Quang-Luu-2005/DKHTM/readme.md

Mapping hiện tại:

  - COM3: camera Face Recognition.
  - COM10: camera stream + ESP-DL Face Detect một tầng.
  - COM11: mạch Automatic Gate gồm servo, RFID, HC‑SR04, LED/buzzer và MQTT.
