Quang-Luu-2005/DKHTM/slide/slide_updated.tex

\documentclass[aspectratio=169,11pt]{beamer}

\usetheme{Madrid}
\useinnertheme{circles}

\usepackage[utf8]{inputenc}
\usepackage[T5]{fontenc}
\usepackage[vietnamese]{babel}
\usepackage{booktabs}
\usepackage{array}
\usepackage{graphicx}
\usepackage{tikz}
\usetikzlibrary{arrows.meta,positioning}

% Bảng màu bám theo bản trình chiếu gốc.
\definecolor{Primary}{HTML}{3733B5}
\definecolor{PrimaryDark}{HTML}{282477}
\definecolor{Success}{HTML}{168A45}
\definecolor{Warning}{HTML}{D66A00}
\definecolor{Danger}{HTML}{C90000}
\definecolor{LightPurple}{HTML}{F1F0FA}
\definecolor{LightRed}{HTML}{FDEDED}
\definecolor{BodyText}{HTML}{161616}

\setbeamercolor{normal text}{fg=BodyText,bg=white}
\setbeamercolor{structure}{fg=Primary}
\setbeamercolor{title}{fg=BodyText,bg=white}
\setbeamercolor{subtitle}{fg=BodyText,bg=white}
\setbeamercolor{frametitle}{fg=white,bg=Primary}
\setbeamercolor{palette primary}{fg=white,bg=Primary}
\setbeamercolor{palette secondary}{fg=white,bg=PrimaryDark}
\setbeamercolor{palette tertiary}{fg=white,bg=Primary}
\setbeamercolor{author in head/foot}{fg=white,bg=PrimaryDark}
\setbeamercolor{title in head/foot}{fg=white,bg=Primary}
\setbeamercolor{date in head/foot}{fg=white,bg=PrimaryDark}
\setbeamercolor{block title}{fg=white,bg=PrimaryDark}
\setbeamercolor{block body}{fg=BodyText,bg=LightPurple}
\setbeamercolor{block title alerted}{fg=white,bg=Danger}
\setbeamercolor{block body alerted}{fg=BodyText,bg=LightRed}

\setbeamerfont{title}{size=\Large,series=\bfseries}
\setbeamerfont{subtitle}{size=\normalsize}
\setbeamerfont{frametitle}{size=\large,series=\mdseries}
\setbeamerfont{normal text}{size=\normalsize}
\setbeamerfont{footline}{size=\tiny}

\setbeamertemplate{blocks}[rounded][shadow=true]
\setbeamertemplate{navigation symbols}{}
\setbeamertemplate{headline}{}
\setbeamertemplate{footline}{%
  \leavevmode%
  \hbox{%
    \begin{beamercolorbox}[wd=.30\paperwidth,ht=2.2ex,dp=.8ex,center]{author in head/foot}%
      \usebeamerfont{footline}\insertshortauthor\ (HCMUS)
    \end{beamercolorbox}%
    \begin{beamercolorbox}[wd=.38\paperwidth,ht=2.2ex,dp=.8ex,center]{title in head/foot}%
      \usebeamerfont{footline}\insertshorttitle
    \end{beamercolorbox}%
    \begin{beamercolorbox}[wd=.22\paperwidth,ht=2.2ex,dp=.8ex,center]{date in head/foot}%
      \usebeamerfont{footline}\insertshortdate
    \end{beamercolorbox}%
    \begin{beamercolorbox}[wd=.10\paperwidth,ht=2.2ex,dp=.8ex,center]{title in head/foot}%
      \usebeamerfont{footline}\insertframenumber
    \end{beamercolorbox}%
  }%
}

\hypersetup{
  unicode=true,
  pdftitle={Hệ thống kiểm soát ra vào thông minh - Báo cáo cuối kỳ và đánh giá mức độ đáp ứng mục tiêu},
  pdfauthor={Lưu Huy Minh Quang, Hoàng Nhân, Trần Cao Vân, Nguyễn Trần Thiên Phú},
  pdfsubject={Đánh giá sản phẩm AIoT với camera, RFID và Web Sentinel}
}

\title[Kiểm soát ra vào AIoT]{Hệ thống kiểm soát ra vào thông minh}
\subtitle{Báo cáo cuối kỳ và đánh giá mức độ đáp ứng mục tiêu}
\author[Nhóm thực hiện]{Lưu Huy Minh Quang \and Hoàng Nhân \and Trần Cao Vân \and Nguyễn Trần Thiên Phú}
\institute[HCMUS]{Khoa Công nghệ Thông tin\\Đại học Khoa học Tự nhiên, ĐHQG TP.HCM}
\date[Tháng 8 năm 2026]{Tháng 8 năm 2026}

\begin{document}

% Trang 1
\begin{frame}[c]
  \centering
  {\usebeamerfont{title}\inserttitle\par}
  \vspace{0.25em}
  {\usebeamerfont{subtitle}\insertsubtitle\par}

  \vspace{1em}
  {\large\bfseries Nhóm thực hiện}\par
  \vspace{0.4em}
  \begin{tabular}{ll}
    Lưu Huy Minh Quang & 23127016 \\
    Hoàng Nhân & 23127094 \\
    Trần Cao Vân & 23127141 \\
    Nguyễn Trần Thiên Phú & 23127246
  \end{tabular}

  \vspace{0.75em}
  \textsl{Khoa Công nghệ Thông tin -- ĐH Khoa học Tự nhiên, ĐHQG TP.HCM}\\
  \textsl{Môn: Nhập môn lập trình điều khiển thiết bị thông minh}

  \vspace{0.7em}
  \insertdate
\end{frame}

% Trang 2
\begin{frame}{Nội dung trình bày}
  \vspace{1.5em}
  \begin{enumerate}
    \item Sản phẩm cuối cùng đang làm được gì?
    \item Các phần từng chưa hoàn thành nay ở trạng thái nào?
    \item Đồ án đáp ứng ba mục tiêu ban đầu đến đâu?
    \item Kết luận và phạm vi của phiên bản hiện tại
  \end{enumerate}
\end{frame}

% Trang 3
\begin{frame}{Kết luận sau khi rà soát toàn bộ đồ án}
  \begin{block}{Sản phẩm đã thành hình ở mức nguyên mẫu một cổng}
    Người dùng có thể đăng ký hồ sơ, dùng khuôn mặt hoặc thẻ để xác thực, mở cổng tự động và theo dõi sự kiện trên trang quản lý.
  \end{block}

  \begin{itemize}
    \item \textbf{\color{Success}Hoàn thành:} nhận diện khuôn mặt, xác thực thẻ, điều khiển cổng, lưu hồ sơ và gửi cảnh báo.
    \item \textbf{\color{Success}Hoàn thành phát hiện hành vi trèo:} cảm biến siêu âm báo vi phạm khi có vật thể trong vùng kiểm soát lúc cổng chưa mở.
    \item \textbf{\color{Warning}Hạn chế:} toàn bộ quá trình nhận diện mất khoảng 5--7 giây.
  \end{itemize}
\end{frame}

% Trang 4
\begin{frame}{Sản phẩm cuối cùng trên trang quản lý}
  \centering
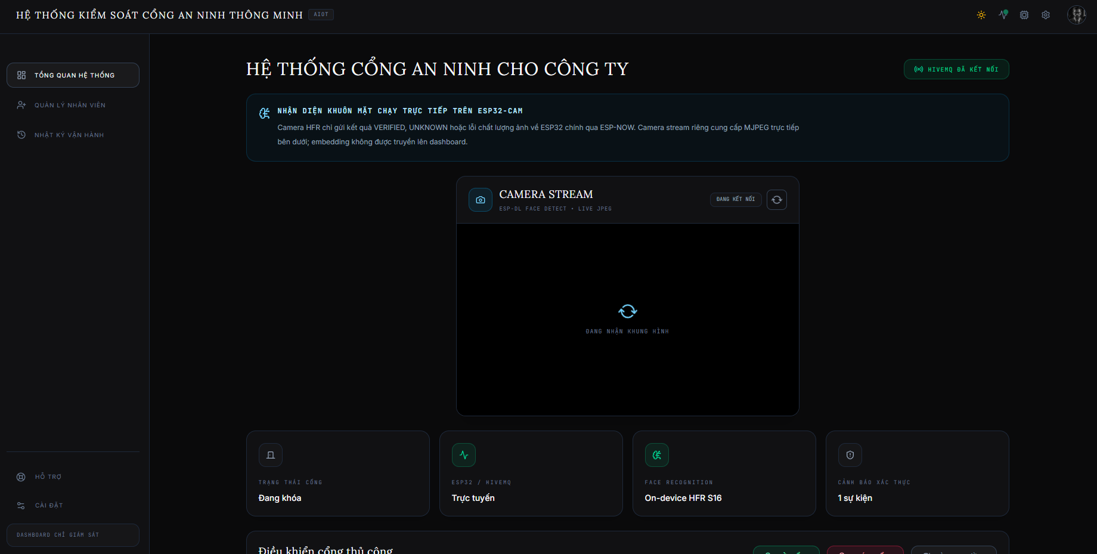
[picture p1: slide/assets/dashboard-overview.png]
  

  \vspace{0.35em}
  \begin{beamercolorbox}[rounded=true,sep=0.55em,wd=0.94\textwidth]{block body}
    \centering\small
    Camera trực tiếp \quad--\quad Trạng thái cổng \quad--\quad Cảnh báo \quad--\quad Điều khiển thủ công
  \end{beamercolorbox}
\end{frame}

% Trang 5
\begin{frame}{Một lượt ra vào diễn ra như thế nào?}
  \centering
  \vspace{0.8em}
  \begin{tikzpicture}[
    node distance=0.42cm,
    flowbox/.style={rounded corners=4pt,draw=Primary,fill=Primary!5,
      minimum width=2.15cm,minimum height=1.3cm,text width=1.9cm,
      align=center,font=\small\bfseries,inner sep=5pt},
    flowarr/.style={-{Stealth[length=2.2mm]},thick,draw=Primary}
  ]
    \node[flowbox] (arrival) {Có người\\đến cổng};
    \node[flowbox,right=of arrival] (identity) {Nhận diện mặt\\hoặc đọc thẻ};
    \node[flowbox,right=of identity] (access) {Kiểm tra\\quyền ra vào};
    \node[flowbox,right=of access] (gate) {Mở cổng\\hoặc giữ khóa};
    \node[flowbox,right=of gate] (history) {Ghi lịch sử\\và cảnh báo};

    \draw[flowarr] (arrival) -- (identity);
    \draw[flowarr] (identity) -- (access);
    \draw[flowarr] (access) -- (gate);
    \draw[flowarr] (gate) -- (history);
  \end{tikzpicture}

  \vspace{1em}
  \begin{block}{Điểm thay đổi so với thiết kế cũ}
    Trang quản lý có thể xem trực tiếp luồng camera tại cổng. Việc nhận diện vẫn được xử lý ngay trên camera và kết quả xác thực được gửi về mạch cổng.
  \end{block}
\end{frame}

% Trang 6
\begin{frame}{Các phần từng chưa hoàn thành: kết quả cuối (1/2)}
  \begin{columns}[T,onlytextwidth]
    \column{0.59\textwidth}
      \centering
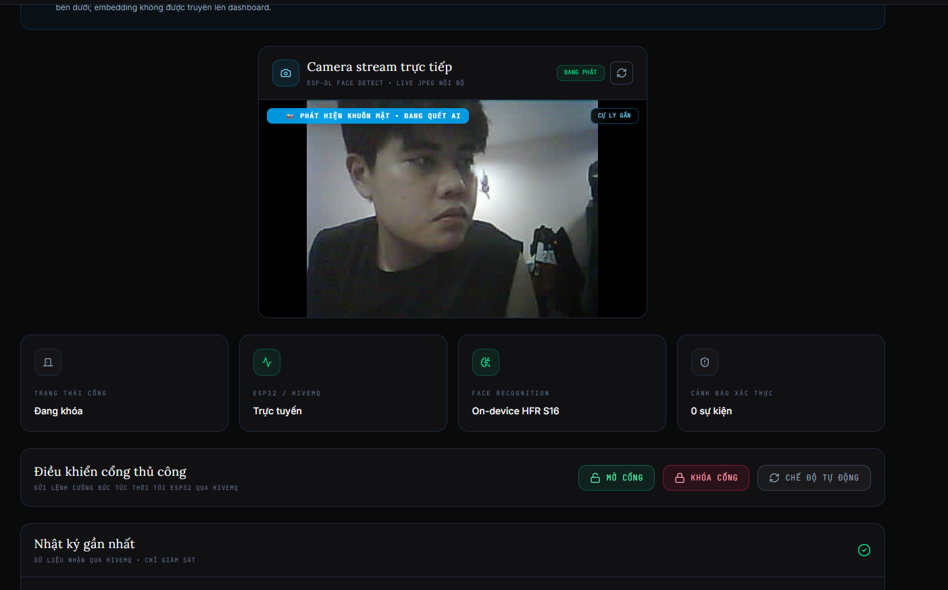
[picture p2: slide/assets/camera-stream.png]
      

      \vspace{0.25em}
      {\footnotesize Luồng camera trực tiếp và trạng thái nhận diện trên dashboard.}

    \column{0.37\textwidth}
      \small
      \begin{itemize}
        \item \textbf{\color{Success}Nhận diện khuôn mặt -- Hoàn thành}

        Đăng ký ba góc mặt và xử lý ngay trên camera.
        \item \textbf{\color{Success}Luồng camera -- Hoàn thành}

        Hình ảnh trực tiếp được hiển thị trên trang quản lý.
        \item \textbf{\color{Success}Phân nhóm email -- Hoàn thành}

        Cảnh báo được gửi đúng vai trò.
      \end{itemize}
  \end{columns}
\end{frame}

% Trang 7
\begin{frame}{Các phần từng chưa hoàn thành: kết quả cuối (2/2)}
  \vspace{1.5em}
  \begin{itemize}
    \item \textbf{\color{Success}Phát hiện trèo -- Hoàn thành:} khi cổng chưa mở mà cảm biến siêu âm phát hiện vật thể trong vùng kiểm soát, hệ thống xác định đây là vi phạm, tiếp tục khóa cổng và gửi cảnh báo.
    \item \textbf{\color{Success}Khôi phục kết nối -- Hoàn thành:} mạch và trang quản lý tự kết nối lại khi Wi-Fi hoặc kênh truyền bị gián đoạn ngắn.
  \end{itemize}
\end{frame}

% Trang 8
\begin{frame}{Mục tiêu 1: Nhận diện được, nhưng phản hồi còn chậm}
  \begin{columns}[T,onlytextwidth]
    \column{0.64\textwidth}
      \small
      \begin{block}{Mục tiêu ban đầu}
        Tối đa 20 người; độ chính xác trên 95\%; phản hồi dưới 1,5 giây.
      \end{block}

      \begin{itemize}
        \item Đăng ký ba góc mặt và lưu dữ liệu trên camera.
        \item Tự nhận diện, kiểm tra quyền và mở cổng khi khớp.
        \item Thời gian phản hồi thực tế: khoảng 5--7 giây.
      \end{itemize}

      \begin{alertblock}{Đánh giá}
        \textbf{Đạt chức năng, chưa đạt mục tiêu tốc độ.}
      \end{alertblock}

    \column{0.32\textwidth}
      \centering
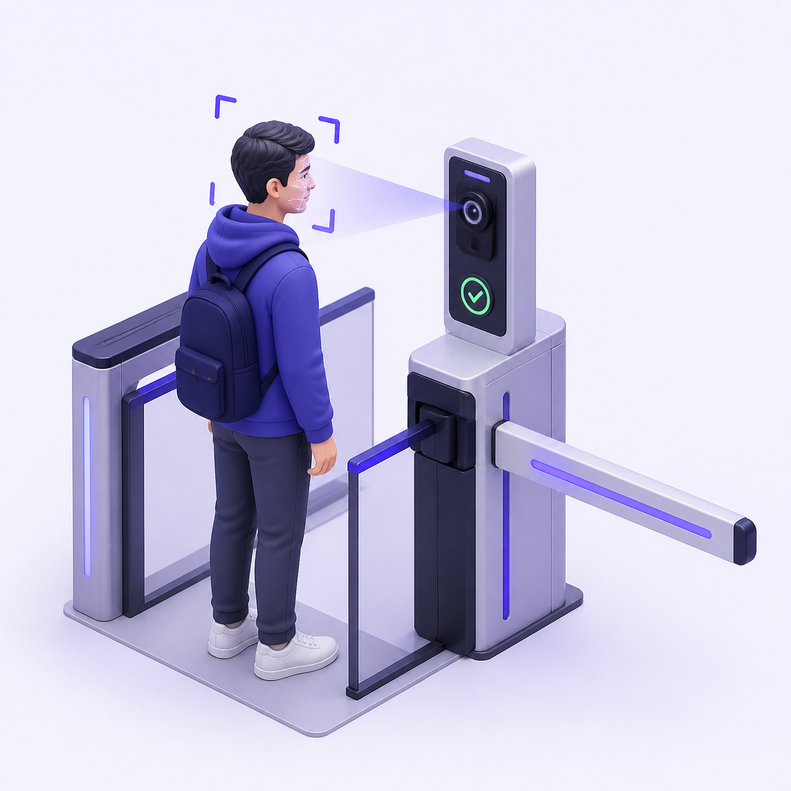
[picture p3: slide/assets/face-recognition.png]
      
      \vspace{0.25em}

      {\footnotesize Nhận diện được xử lý ngay tại camera.}
  \end{columns}
\end{frame}

% Trang 9
\begin{frame}{Mục tiêu 2: Phát hiện trèo bằng cảm biến siêu âm}
  \begin{columns}[T,onlytextwidth]
    \column{0.57\textwidth}
      \small
      \begin{block}{Mục tiêu ban đầu}
        Phát hiện vượt cổng trái phép, giữ khóa và gửi cảnh báo.
      \end{block}

      \begin{itemize}
        \item Cảm biến theo dõi vùng kiểm soát khi cổng đóng.
        \item Có vật thể bất thường: giữ khóa và gửi cảnh báo.
        \item Cổng đã mở hợp lệ: không kích hoạt cảnh báo.
      \end{itemize}

      \begin{alertblock}{Đánh giá}
        \textbf{Đạt mục tiêu phát hiện và cảnh báo.}
      \end{alertblock}

    \column{0.39\textwidth}
      \centering
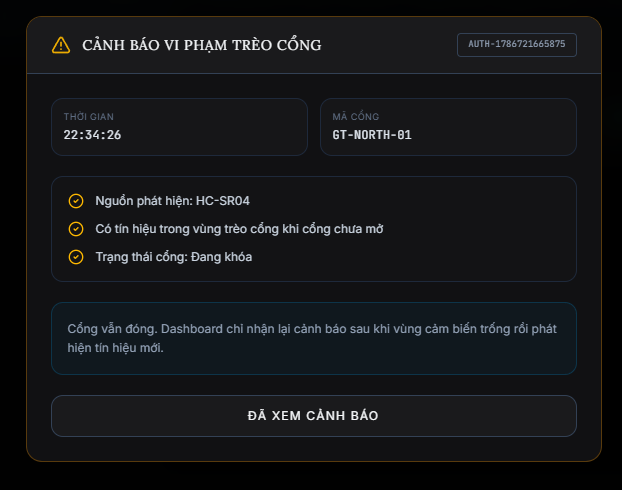
[picture p4: slide/assets/violation-alert.png]
      
      \vspace{0.25em}

      {\footnotesize Cảnh báo thực tế từ cảm biến HC-SR04.}
  \end{columns}
\end{frame}

% Trang 10
\begin{frame}{Mục tiêu 3: Luồng RFID/NFC hoàn chỉnh}
  \begin{columns}[T,onlytextwidth]
    \column{0.64\textwidth}
      \small
      \begin{block}{Mục tiêu ban đầu}
        Xác thực và mở cổng dưới 2 giây; độ chính xác tối thiểu 98\%.
      \end{block}

      \begin{itemize}
        \item Quét, gán và phân biệt thẻ hợp lệ hoặc không hợp lệ.
        \item Danh sách thẻ được lưu ngay trên mạch để xử lý nhanh.
        \item Mở cổng, đổi đèn và ghi lịch sử tại chỗ.
      \end{itemize}

      \begin{alertblock}{Đánh giá}
        \textbf{Đạt mục tiêu chức năng.}
      \end{alertblock}

    \column{0.32\textwidth}
      \centering
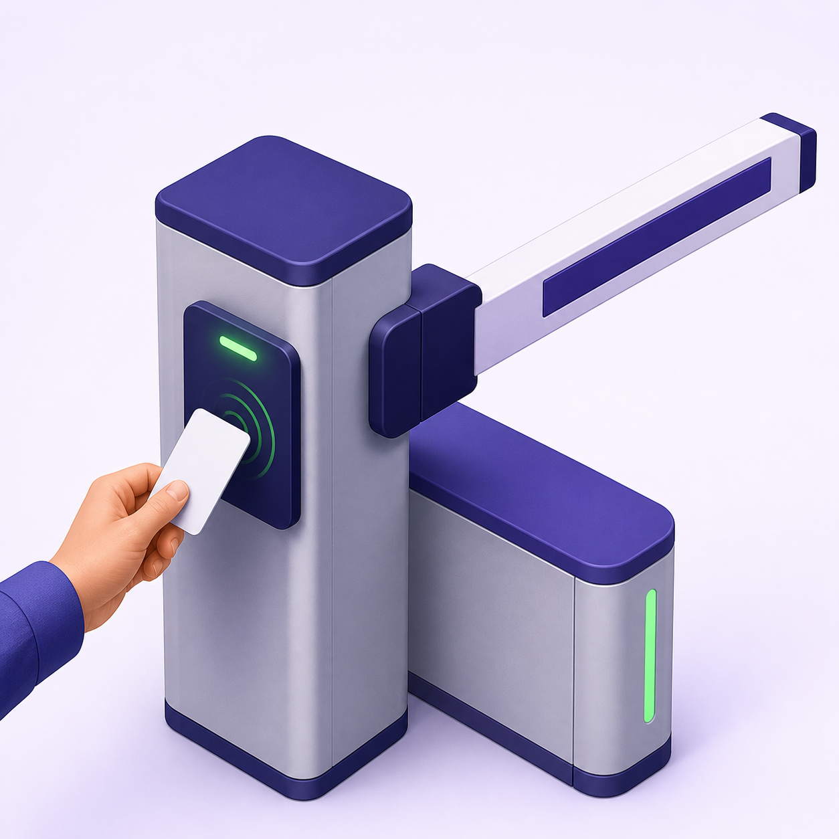
[picture p5: slide/assets/rfid-access.png]
      
      \vspace{0.25em}

      {\footnotesize Thẻ được kiểm tra trực tiếp tại cổng.}
  \end{columns}
\end{frame}

% Trang 11
\begin{frame}{Tổng hợp mức độ đáp ứng ba mục tiêu}
  \centering
  \small
  \renewcommand{\arraystretch}{1.32}
  \begin{tabular}{>{\raggedright\arraybackslash}p{2.45cm}
                  >{\raggedright\arraybackslash}p{5.35cm}
                  >{\raggedright\arraybackslash}p{3.0cm}}
    \toprule
    \textbf{Mục tiêu} & \textbf{Kết quả sản phẩm} & \textbf{Mức đáp ứng} \\
    \midrule
    Nhận diện người
      & Nhận diện và mở cổng; toàn bộ quá trình mất khoảng 5--7 giây
      & \textbf{\color{Warning}Đạt chức năng, còn chậm} \\
    Phát hiện trèo hoặc vượt cổng
      & Cảm biến phát hiện vật thể khi cổng chưa mở, giữ khóa và gửi cảnh báo
      & \textbf{\color{Success}Đạt} \\
    RFID/NFC
      & Quét thẻ, kiểm tra quyền, mở cổng và ghi lịch sử
      & \textbf{\color{Success}Đạt} \\
    \bottomrule
  \end{tabular}
\end{frame}

% Trang 12
\begin{frame}{Kiến trúc sản phẩm cuối cùng}
  \centering
  \begin{tikzpicture}[
    node distance=0.75cm and 0.75cm,
    archbox/.style={rounded corners=5pt,minimum width=3.05cm,minimum height=1.55cm,
      text width=2.75cm,align=center,font=\small\bfseries,inner sep=6pt,thick},
    archarr/.style={-{Stealth[length=2.4mm]},thick,draw=Primary},
    syncarr/.style={{Stealth[length=2.4mm]}-{Stealth[length=2.4mm]},thick,draw=Warning}
  ]
    \node[archbox,draw=Primary,fill=Primary!6] (input)
      {Thiết bị đầu vào\\{\footnotesize Camera + thẻ + cảm biến}};
    \node[archbox,draw=PrimaryDark,fill=Primary!10,right=of input] (control)
      {Mạch điều khiển cổng\\{\footnotesize Kiểm tra quyền ra vào}};
    \node[archbox,draw=Success,fill=Success!8,right=of control] (output)
      {Thiết bị phản hồi\\{\footnotesize Servo + đèn + còi}};
    \node[archbox,draw=Warning,fill=Warning!7,below=0.85cm of control] (web)
      {Trang quản lý\\{\footnotesize Hồ sơ + lịch sử + email}};

    \draw[archarr] (input) -- (control);
    \draw[archarr] (control) -- (output);
    \draw[syncarr] (control) -- node[left,font=\footnotesize]{Trạng thái / lệnh đăng ký} (web);
  \end{tikzpicture}

  \vspace{0.65em}
  \begin{minipage}{0.96\textwidth}
    \small
    \textbf{Nguyên tắc chính:} nhận diện được xử lý ngay tại camera; mạch cổng quyết định mở hoặc đóng; trang quản lý dùng để quản lý hồ sơ, theo dõi và nhận cảnh báo.
  \end{minipage}
\end{frame}

% Trang 13
\begin{frame}{Phạm vi của phiên bản cuối}
  \vspace{1em}
  \begin{columns}[T,onlytextwidth]
    \column{0.48\textwidth}
      \textbf{Có thể trình diễn}
      \begin{itemize}
        \item Đăng ký hồ sơ, khuôn mặt và thẻ.
        \item Mở cổng bằng khuôn mặt hoặc RFID.
        \item Phát hiện trèo khi cảm biến có tín hiệu lúc cổng chưa mở.
        \item Từ chối người hoặc thẻ không hợp lệ.
        \item Hiển thị lịch sử và gửi cảnh báo.
      \end{itemize}

    \column{0.48\textwidth}
      \textbf{Giới hạn còn lại}
      \begin{itemize}
        \item Toàn bộ quá trình nhận diện khuôn mặt cần khoảng 5--7 giây.
        \item Nhật ký chủ yếu được lưu trên trình duyệt đang sử dụng.
      \end{itemize}
  \end{columns}
\end{frame}

% Trang 14
\begin{frame}{Kết luận}
  \begin{block}{Kết quả cuối kỳ}
    Nhóm đã xây dựng được một nguyên mẫu kiểm soát ra vào có đủ luồng người dùng, thiết bị và trang quản lý để trình diễn. Điểm mạnh là xác thực RFID và nhận diện khuôn mặt ngay trên thiết bị.
  \end{block}

  \vspace{0.35em}
  \begin{alertblock}{Kết luận so với ba mục tiêu}
    Mục tiêu 2 và 3 đạt yêu cầu trong sản phẩm. Mục tiêu 1 đạt chức năng phát hiện và nhận diện người dùng, nhưng toàn bộ quá trình mất khoảng 5--7 giây, chậm hơn mục tiêu ban đầu.
  \end{alertblock}

  \vfill
  \centering
  {\Large\bfseries Hỏi đáp và thảo luận}
\end{frame}

\end{document}
