Quang-Luu-2005/DKHTM/Project2/Feature slide/slide/figures/Luồng RFIDNFC.png

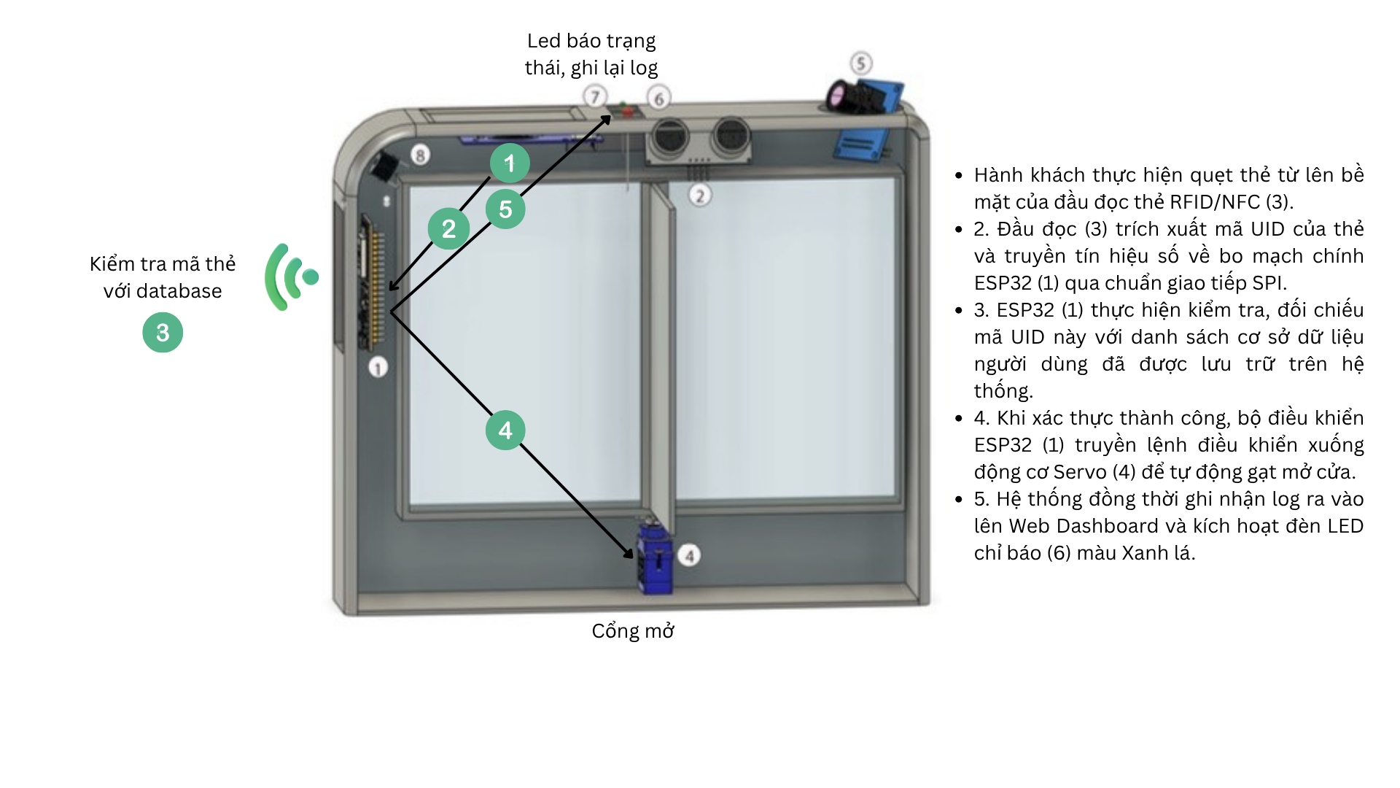
Project2/Feature slide/slide/figures/Luồng RFIDNFC.png
