Quang-Luu-2005/DKHTM/source/hardware/mqtt_main_controller/include/Gate.h

#include <ESP32Servo.h>

const int GATE_OPEN_DURATION = 1000;
const int GATE_OPEN_ANGLE = 70;
const int GATE_CLOSE_ANGLE = 0;

enum GATE_STATE {
  GATE_CLOSED,
  GATE_OPEN,
};

struct Gate {
  int pin;
  int angle;
  GATE_STATE state;
  unsigned long timer;

  Servo servo;
  Gate(int pin);
  void init();
  void open();
  void close();
};
