Quang-Luu-2005/DKHTM/source/hardware/esp32cam_node/json_utils.h

#pragma once

#include <Arduino.h>

#include "app_state.h"
#include "config.h"

static String escapeJson(const String& value) {
  String escaped;
  escaped.reserve(value.length() + 8);

  for (size_t i = 0; i < value.length(); ++i) {
    const char ch = value.charAt(i);
    switch (ch) {
      case '\\':
        escaped += "\\\\";
        break;
      case '"':
        escaped += "\\\"";
        break;
      case '\n':
        escaped += "\\n";
        break;
      case '\r':
        escaped += "\\r";
        break;
      case '\t':
        escaped += "\\t";
        break;
      default:
        escaped += ch;
        break;
    }
  }

  return escaped;
}

static String normalizeIdentityName(String value) {
  value.trim();
  value.replace("\n", " ");
  value.replace("\r", " ");
  value.replace("\t", " ");

  while (value.indexOf("  ") >= 0) {
    value.replace("  ", " ");
  }

  if (value.length() > kMaxEnrollNameLength) {
    value = value.substring(0, kMaxEnrollNameLength);
    value.trim();
  }

  return value;
}

static bool queryFlag(const char* name, bool defaultValue = false) {
  if (!webServer.hasArg(name)) {
    return defaultValue;
  }

  String value = webServer.arg(name);
  value.trim();
  value.toLowerCase();
  return value == "1" || value == "true" || value == "yes" || value == "on";
}

static int queryInt(const char* name, int defaultValue, int minValue, int maxValue) {
  if (!webServer.hasArg(name)) {
    return defaultValue;
  }

  int value = webServer.arg(name).toInt();
  if (value < minValue) {
    return minValue;
  }
  if (value > maxValue) {
    return maxValue;
  }
  return value;
}

static String faceRecognitionMode() {
  return "embedding/backend-match";
}
