Quang-Luu-2005/DKHTM/source/hardware/esp32cam_gateway/include/wifi_secrets.example.h

#pragma once

// Copy this file to wifi_secrets.h and use the same 2.4 GHz Wi-Fi as the gate ESP32.
constexpr const char* WIFI_SSID = "YOUR_2_4_GHZ_WIFI";
constexpr const char* WIFI_PASSWORD = "YOUR_WIFI_PASSWORD";
