Quang-Luu-2005/DKHTM/source/hardware/mqtt_main_controller/include/MQTT_secrets.example.h

#pragma once

// Copy this file to MQTT_secrets.h and fill in the local credentials.
constexpr const char* WIFI_SSID = "YOUR_WIFI_SSID";
constexpr const char* WIFI_PASSWORD = "YOUR_WIFI_PASSWORD";
constexpr const char* MQTT_SERVER = "YOUR_CLUSTER.s1.eu.hivemq.cloud";
constexpr const char* MQTT_USERNAME = "YOUR_MQTT_USERNAME";
constexpr const char* MQTT_PASSWORD = "YOUR_MQTT_PASSWORD";
