Quang-Luu-2005/DKHTM/(commit log)

2026-05-29 Add presentation on Smart Security Door using Face Recognition
    - Introduced a new Beamer presentation titled "Cửa an ninh xác thực bằng khuôn mặt"
    - Included sections covering project introduction, technology selection, proposed methods, and system architecture
    - Detailed the use of YOLOv11 for face detection, ArcFace for face embedding, and liveness detection techniques
    - Provided a comprehensive overview of the system's architecture and control loop for intelligent device management
    - Added references for related works and technologies used in the project
2026-05-29 feat: Add arduino test for ESP32CAM
2026-06-07 fix: gitignore; feat: Cam test available
    [camera_pins.h, main.cpp]
2026-06-12 fix: change Mục tiêu 2, and add more item, adjust tools list
2026-06-27 sửa mục đích, mục tiêu
2026-07-01 feat: update hardware documentation for smart access control system, enhancing component mapping and adding ultrasonic sensor details
2026-07-01 feat: enhance documentation for smart access control system, adding details on ESP32-CAM functionality and embedding processing flow
2026-07-02 Refactor project structure and remove deprecated files
    - Deleted project_config.h and secrets.example.h as they are no longer needed.
    - Removed device_events.h, exit_button.h, gate_control.h, heartbeat.h, indicators.h, intrusion_monitor.h, rfid_access.h, sensors.h, camera_pins.h, and main_controller_pins.h headers.
    - Eliminated corresponding implementation files for device events, exit button handling, gate control, heartbeat sending, indicators, intrusion monitoring, RFID access, and sensor management.
    - Removed backend_client and wifi_manager implementations as they are no longer utilized.
    - Added new main sketches for esp32cam_node and main_controller with updated logic.
    - Introduced plat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
    [backend_client.cpp, backend_client.h, camera_pins.h, camera_service.cpp, camera_service.h, esp32cam_node.ino, main.cpp, main_controller.ino]
2026-07-04 Refactor ESP32-CAM and Main Controller Code Structure
    - Moved esp32cam_node.ino and main_controller.ino to a new hardware directory for better organization.
    - Updated platformio.ini to reflect new source directory structure.
    - Reimplemented esp32cam_node.ino with enhanced web server capabilities for live streaming and snapshot functionality.
    - Added a new JavaScript application (app.js) for managing the ESP32-CAM interface, including status checks and stream controls.
    - Created HTML (index.html) and CSS (styles.css) files for the web interface, providing a user-friendly experience for interacting with the ESP32-CAM.
    - Removed old platformio wrapper files as they are no longer needed with the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
    [esp32cam_node.ino, main_controller.ino]
2026-07-06 Enhance ESP32-CAM functionality with face detection and recognition features
    - Updated documentation to reflect the new structure and capabilities of the ESP32-CAM system, including face detection and recognition.
    - Modified platformio.ini to include partition configuration for face recognition.
    - Implemented face detection and recognition logic in esp32cam_node.ino, including endpoints for enrolling and managing identities.
    - Added new CSS styles for face result display and identity management in the web interface.
    - Created a new partition layout for storing face recognition data.
    [partitions_esp32cam_face.csv]
2026-07-06 feat: add fast stream and frame detection options to ESP32-CAM functionality
2026-07-07 Add face recognition and camera services for ESP32-CAM
    - Introduced configuration header (config.h) for WiFi and camera settings.
    - Created types header (types.h) for face processing options and outcomes.
    - Implemented face engine functionality in face_engine.cpp and face_engine.h.
    - Developed backend client for handling HTTP requests to a server (backend_client.cpp, backend_client.h).
    - Established camera service for initializing camera hardware and capturing frames (camera_service.cpp, camera_service.h).
    - Added JSON utility functions for escaping strings and handling query parameters (json_utils.cpp, json_utils.h).
    - Built web server handlers for managing HTTP requests and responses (web_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
2026-07-11 fix: update include paths for face recognition and detection models
    [app_state.h]
2026-07-11 fix: images in Devices flow
2026-07-12 Add ESP32-CAM face recognition and camera service implementation
    - Introduced a new skill for verifying ESP32 firmware builds and hardware behavior.
    - Created app_state.h to manage application state variables for the ESP32-CAM.
    - Implemented backend_client.h for handling Wi-Fi connections and JSON uploads to a backend server.
    - Developed camera_service.h for initializing camera hardware and capturing frames.
    - Added config.h for configuration constants including Wi-Fi credentials and camera settings.
    - Implemented face_engine.h for face detection and recognition functionalities.
    - Created json_utils.h for JSON handling utilities.
    - Defined types.h for face processing options and outcomes.
    -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
2026-07-15 refactor: update stream button functionality and improve UI text for clarity
2026-07-15 chore: remove obsolete settings and verification documentation for ESP32
2026-07-15 feat: initialize backend structure with Express, Prisma, and SSE support
    - Set up Express server with health check and event stream endpoints.
    - Implement middleware for CORS, error handling, and request validation.
    - Create configuration management using Zod for environment variables.
    - Define domain models and serialization functions for users, audit logs, and hardware states.
    - Establish routes for user management, device events, hardware commands, and logging.
    - Integrate Prisma for database interactions and define necessary services for device and hardware management.
    - Add snapshot handling for camera images with file storage.
    - Implement integration tests for API endpoints, device ded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
    [backend_client.h]
2026-07-17 add: base code for gate logic
    RFID, Ultrasonic, Buzzer, Servo
    [Button.cpp, Buzzer.cpp, Buzzer.h, Card.cpp, Gate.cpp, Gate.h, Led.cpp]
2026-07-17 add: Van's Source and can run
    [partitions_esp32cam_face.csv]
2026-07-18 feat: update server base URL in config and adjust camera stream URL in DashboardView; add package-lock.json for root and software directories
2026-07-18 feat: add comprehensive documentation for ESP32-CAM connection, snapshot, and live stream handling
2026-07-25 feat: Integrate ESP32-CAM with gate controller for face recognition and RFID access
    - Implemented backend client for ESP32-CAM to send events to the server.
    - Added access policy service to handle access decisions based on face recognition and RFID scans.
    - Enhanced hardware service to support logging and audit for hardware state changes.
    - Updated user service to normalize RFID UID format.
    - Improved dashboard and registration views to display access logs and user registration status.
    - Created documentation for ESP32-CAM integration, detailing data flow, event contracts, and GPIO configurations.
    - Added safety button and ultrasonic sensor functionalities to the main controller.
    - Refactore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
2026-07-25 feat: add face enrollment and matching services
    - Implemented face enrollment service to handle user face data and embeddings.
    - Added face matching service to compare embeddings and determine access decisions.
    - Created portrait storage service for managing user portrait images.
    - Introduced database migrations for FaceProfile and resetting unbacked face statuses.
    - Updated user types to include UserSaveRequest for face enrollment.
    - Added tests for face flow integration, ensuring proper enrollment and access control.
    - Configured GPIO pin mappings for hardware components in pin_config.h.
    - Enhanced CSS for background color classes in frontend styles.
    [backend_client.cpp, backend_client.h, camera_service.h, config.h]
2026-08-01 refactor: migrate backend client, gate actuator, RFID reader, safety button, status indicators, and ultrasonic sensor to inline methods; remove unused files
2026-08-05 add on-device face enrollment workflow
    [partitions.csv]
2026-08-05 Add config, add more camera
2026-08-08 feat: integrate vercel config, cloud vector display, and ultrasonic threshold fix
    [partitions.csv]
2026-08-13 Add final report slides for AIoT access control system; update presentation format and content
    - Introduced a new PDF report detailing the final project outcomes and objectives met.
    - Updated LaTeX presentation to enhance visual styling and structure, including color themes and font adjustments.
    - Revised content to reflect the current status of the project, including completed functionalities and limitations.
    - Removed outdated media files that are no longer needed for the presentation.
2026-08-13 Update presentation slides with improved content and add new images for face recognition, RFID access, and ultrasonic detection
2026-08-14 Cập nhật tài liệu
2026-08-14 Deploy web qua vercel, luồng stream qua ngrok
2026-08-14 feat: enable high-frequency continuous frame rendering
2026-08-14 feat: smooth sequential frame pipeline without reload spam
2026-08-14 fix: correct onSaveUser prop reference in RegistrationView
2026-08-14 feat: live face detected and AI scanning badge overlay on camera stream
2026-08-14 feat: add emergency reset button handler on gate controller (GPIO 17)
2026-08-14 feat: transform button (GPIO 17) into New Session Reset trigger
    [main.cpp]
2026-08-14 fix: add INPUT_PULLDOWN and debounce to Button to prevent floating pin continuous beeps
    [Button.cpp]
2026-08-14 fix(hfr): switch camera sensor to PIXFORMAT_JPEG for razor-sharp face detection and enrollment
    [main.cpp]
2026-08-14 fix(hfr): explicitly use fixed QVGA dimensions (320x240) for JPEG decoding into BGR888
    [main.cpp]
2026-08-14 fix: send enrollment results via broadcast and relax sequence matching on gate
    [main.cpp]
2026-08-14 fix(hfr): correct tensor dimensions, flush frame buffer, and enable AEC/AWB/fallback detection
    [main.cpp]
2026-08-14 fix(hfr): increase enrollment step interval to 4.5s and retry attempts to 50
    [main.cpp]
2026-08-15 chỉnh sửa nội dung web
2026-08-15 Sửa header
